GaryBlackbourne/raspberry-robot/resources/partlists/ctrl-board.md

# List of parts for the control board

## Microcontroller

- STM32F103C8T6 (LQFP-48): [link](https://hu.farnell.com/stmicroelectronics/stm32f103c8t6/mcu-32bit-cortex-m3-72mhz-lqfp/dp/1447637)
## Motor drivers

- BD6220F-E2 (servo driver) X 2: [link](https://hu.farnell.com/rohm/bd6220f-e2/h-bridge-driver-18v-0-5a-sop8/dp/1716260)

- TMC2208 module (step driver): [link](https://hu.farnell.com/trinamic/tmc2208silentstepstick/eval-board-stepper-motor-driver/dp/3861298)

## Connectors

- pin arrays
 - [1 x 6] 2.54mm male X 2
 - [1 x 5] 2.54mm male X 4
 - [2 x 5] 2.54mm female X 1
 - [1 x 4] 2.54mm male X 1
 - [1 x 3] 2.54mm male X 2

## LEDs

- 0805 SMD LED 

## buttons

- 6mm x 6mm x 9.5mm SMD PushButton X 2

## Passives

### Capacitors

All capacitors are SMD 0805 type components

- 100n X 7
- 1u X 1
- 47u X 4

### Resistors

All resistors are SMD 0805 type components

- 100 X 2 
- 1k X 1
- 4.7k X 4
- 10k X 6
- 100k X 2
