GaryBlackbourne/raspberry-robot/resources/partlists/mechanics.md

# List of mechanical parts

## Frame

## Motors

- N20E-06-25 (motor): [link](https://www.hestore.hu/prod_10042880.html)
- 17HS40-1204 léptetőmotor: [link](https://www.hestore.hu/prod_10036719.html)

## wheels
- N20-3PI-WHL (wheel): [link](https://www.hestore.hu/prod_10042770.html)
