GaryBlackbourne/raspberry-robot/doc/university/2_doc/msc_onlab_2_prezentacio.pdf

# Beágyazott Linux alapú modell autó

Készítette: Koloszár Gergely Konzulens: Bányász Gábor

# Motiváció

- önálló laboratórium 1 projekt folytatása
- Teljes rendszer megalkotása (közben mindenféle tapasztalat)
- hosszabb több féléves projekt ● hardware firmware és linux

driver összefüggések

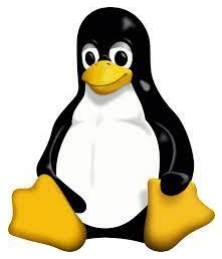
[picture p9: figure]
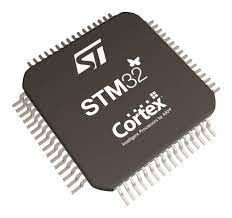
[picture p10: figure]
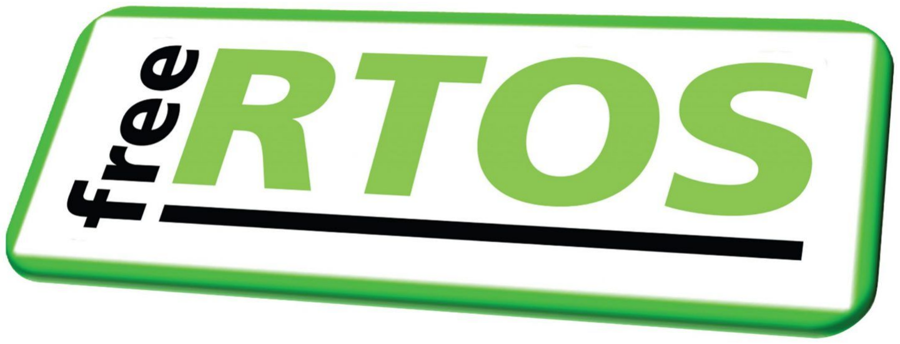
[picture p11: figure]

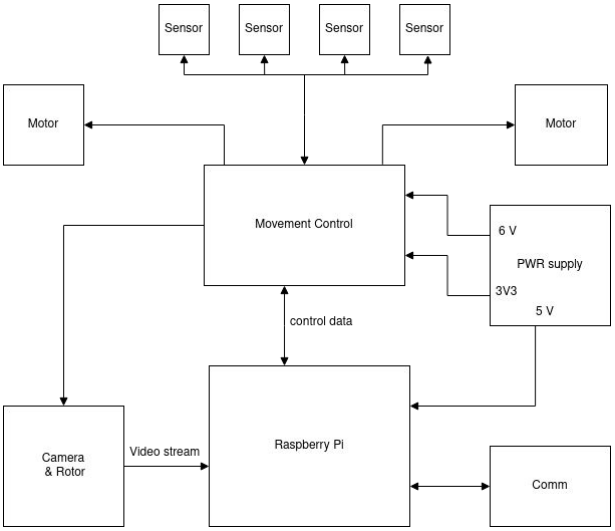
[picture p12: figure]

# A tervezett rendszer

A rendszer blokkdiagrammja

# Előrehaladások az elmúlt félévben

- Elkészült rendszerterv
- Kész alkatrész lista
- Kész PCB schematicok és layoutok
- Elkészült PCB-k

# Idei tervek

- forrasztás és élesztés
- firmware megírása
- linux driver megírása
- táp áramkört újra kellett tervezni

Ebből sajnos nem jött össze minden…

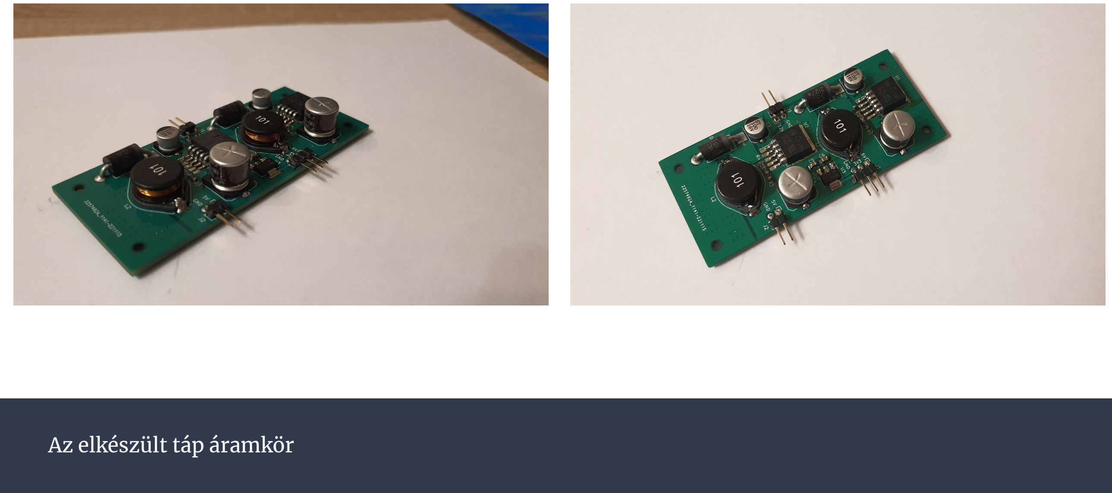
[picture p13: page 6]

Az elkészült táp áramkör

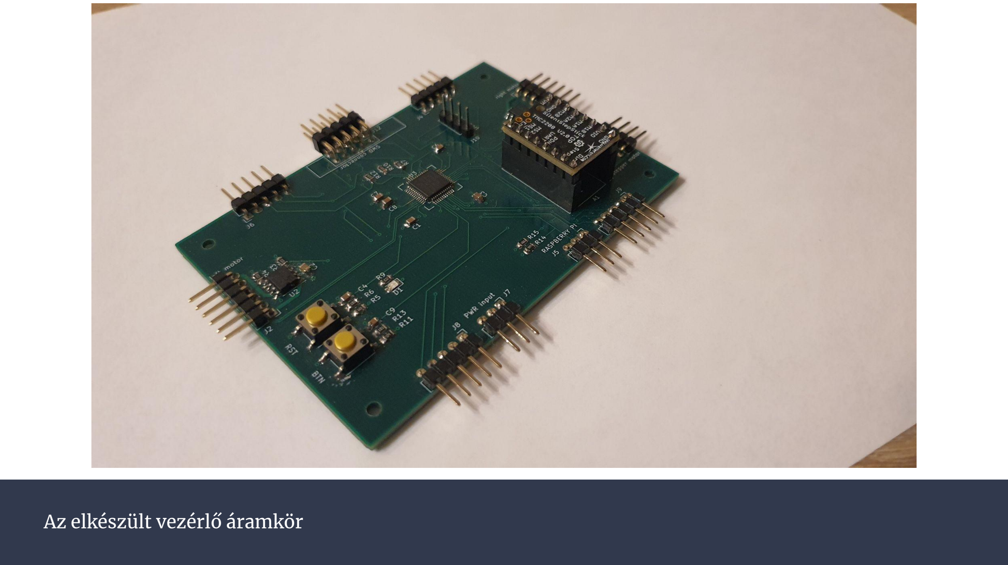
[picture p14: page 7]

Az elkészült vezérlő áramkör

A vezérléshez használt mikrovezérlő egy STM32F103C8.
A firmware megírásához több “keretrendszer” létezik:
- ST - HAL Driver
- ST - LL Driver
- ARM - CMSIS

# Firmware

És a fejlesztői környezetben is tág a választék:
- STM32CubeIDE
- IAR Workbench
- saját környezet

A választásom a saját környezetre, és a CMSIS rendszerre épül.
- alacsony szintről megérthetőek a működések
- CMSIS kód kompatibilis minden ARM mikrovezérlővel
- jobban személyre szabható a környezet

# Firmware

A projektben ezen felül a FreeRTOS operációs rendszerrel dolgozom

Lényegében a projekt befejezése: ● mechanikai váz ● működő akkumulátoros

tápellátás
- teljes linux driver ● teljes firmware ● felhasználói program

# Fejlesztési lehetőségek

# Köszönöm a figyelmet!
