GaryBlackbourne/raspberry-robot/doc/university/1_doc/hqxcd0-presentation.pdf

# Beágyazott Linux alapú modell autó

Készítette: Koloszár Gergely Konzulens: Bányász Gábor

# Motiváció

- teljes rendszer megépítése ● szoftver és hardver

interakcióban tapasztalat
szerzés
- Hosszabb, több féléves projekt

# A projekt célja

- Bővíthető rendszer
létrehozása:
- későbbi fejlesztések
könnyű eszközölhetősége
- többcélú eszköz, esetleg több konfigurációban is
használható
- Három fő területen való
fejlődés:
- PCB tervezés
- Firmware (STM32
platformon)
- Beágyazott Linux

# Specifikáció

- Egy önjáró vagy távirányítható kisautó létrehozása
- Moduláris elemekből ○ akkumulátoros tápellátás ○ motor vezérlés (STM32) ○ Központi vezérlés

(Raspberry Pi)
- Első konfiguráció ○ forgatható kamera ○ vezeték nélküli

kommunikáció


# A tervezett rendszer

A rendszer blokkdiagrammja

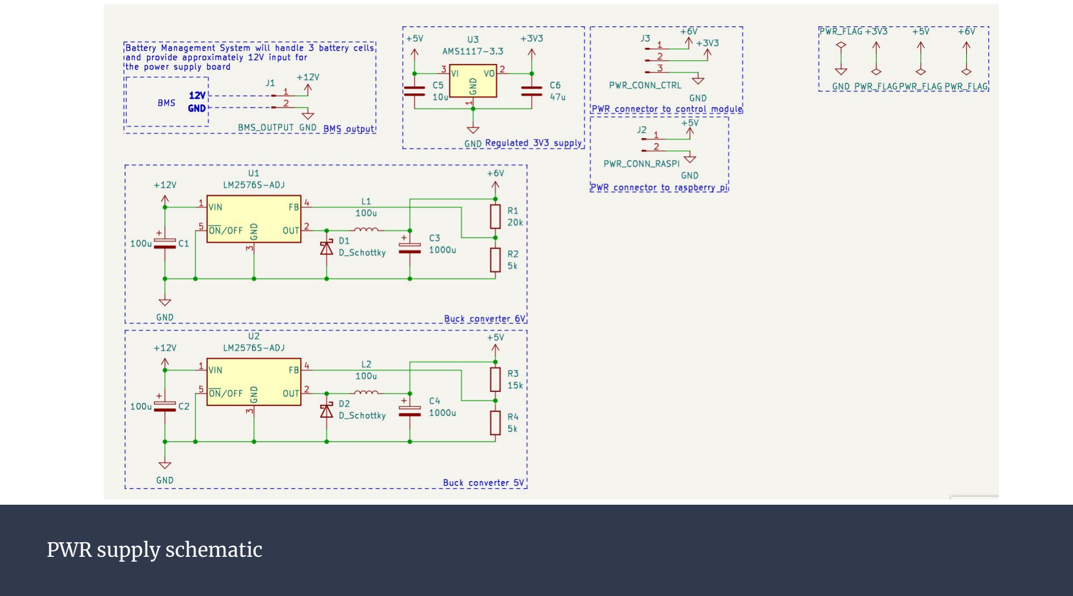
[picture p15: page 6]

PWR supply schematic

PWR supply layout

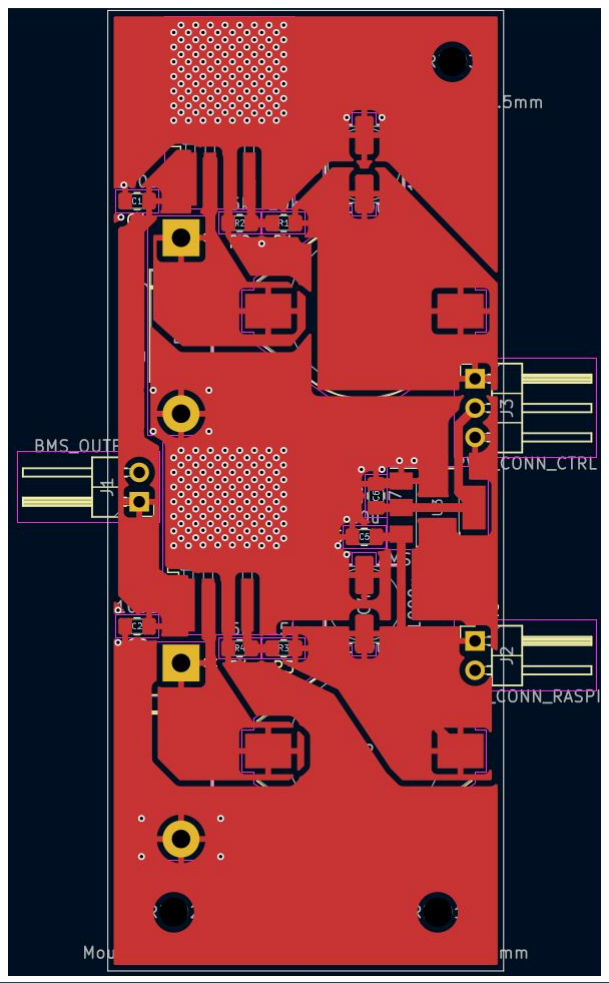
[picture p16: figure]

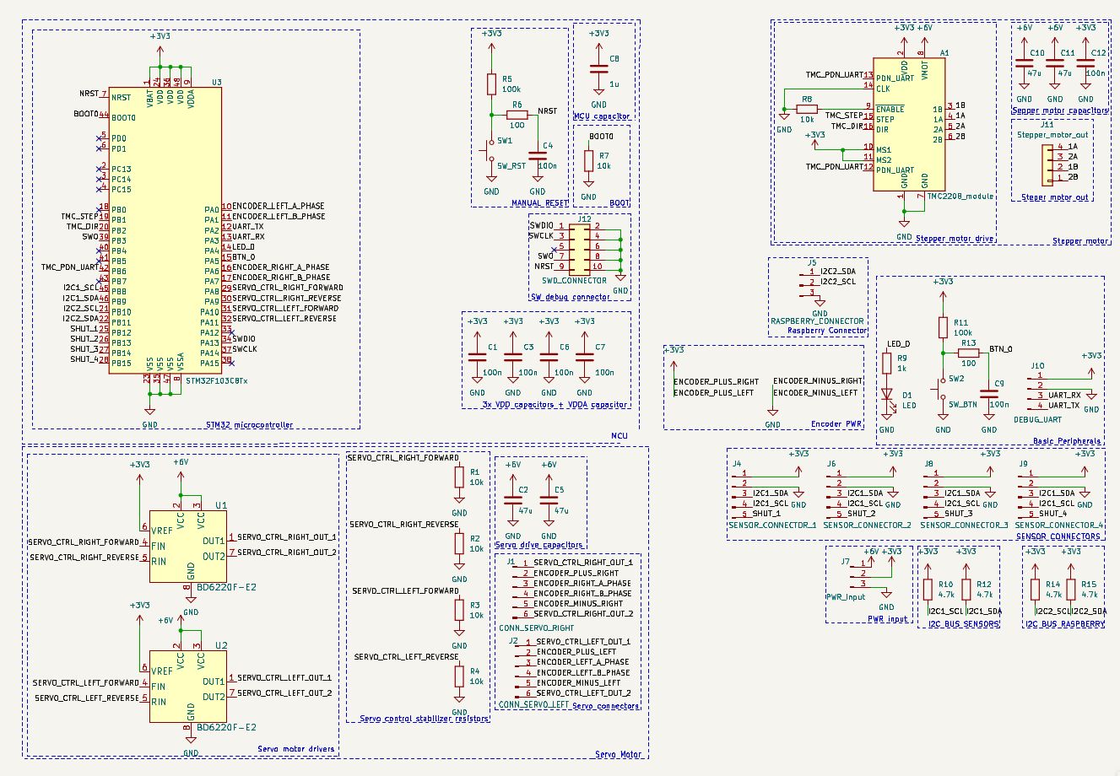
[picture p17: figure]

Movement control schematic

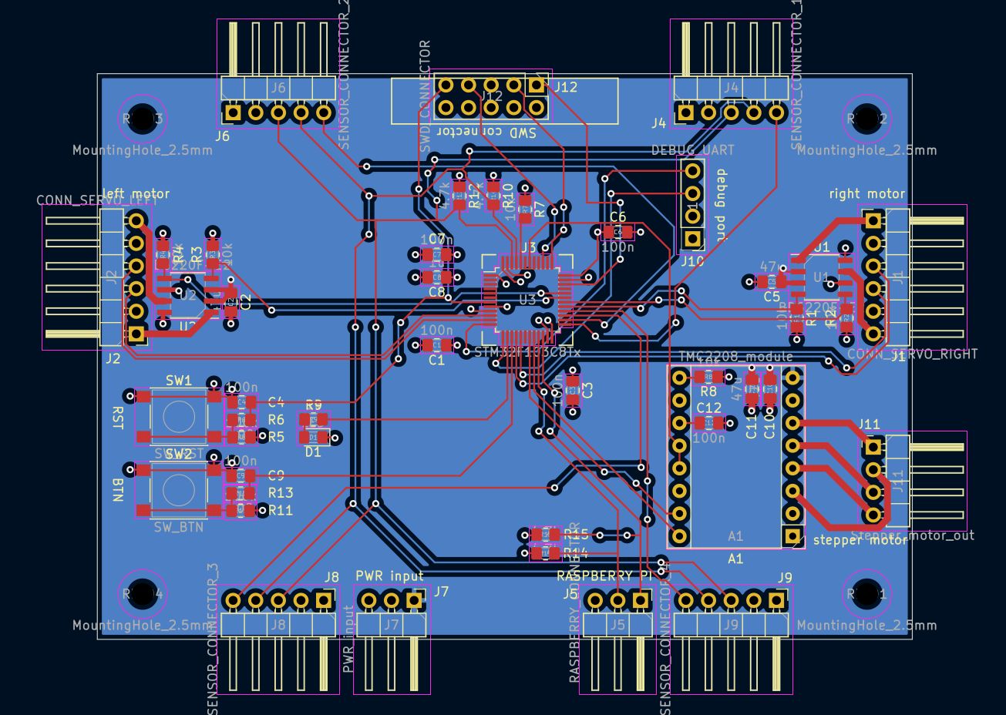
[picture p18: figure]

Movement control layout

# Fejlesztési lehetőségek

- gyorsulás mérő ● nagyobb távolságú vezeték

nélküli kommunikációs modul
- saját akkumulátor
management
- töltési lehetőség megbontás nélkül

# Köszönöm a figyelmet!
