GaryBlackbourne/raspberry-robot/doc/schemas/auto-schema.drawio.png

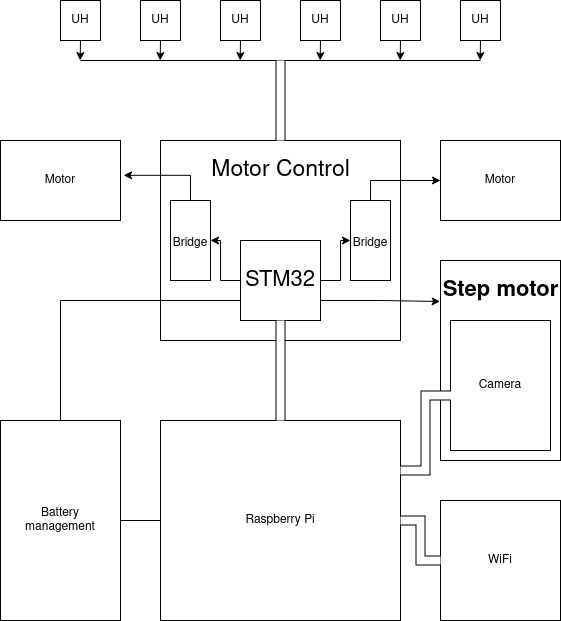
doc/schemas/auto-schema.drawio.png
