GaryBlackbourne/raspberry-robot/resources/partlists/pwr-supply.md

# List of parts for the power supply board

## Switching power supply IC-s

## LDO-s
- AMS1117-3.3 (regulator): 

## Connectors

- [1 x 2] 2.54mm male X 2
- [1 x 3] 2.54mm male X 1

## Passives 

### Capacitors

- 10u 0805 X 1
- 47u 0805 X 1
- 100u 6.3x7.7 X 2
- 1000u 10x10 X 2

### Resistors

All resistors are SMD 0805 type components

- 5k X 2
- 15k X 1
- 20k X 1

### Inductors

- 100u X 2

### Diodes

- 

# List of parts for the Battery module

- BMS
- 18650 battery (30W) [link](https://www.intercell.hu/samsung_18650_37v_3500mah_inr18650-35e_li-ion_ipari_cella_akkuakkumulator_31873)
- battery nest [link](https://www.intercell.hu/li_ion_18650_akkuakkumulator_tartofeszek_3_cellas_sorosparhuzamos_17129)
