GaryBlackbourne/raspberry-robot/resources/partlists/sensors.md

# List of sensors

## Range sensors:
 - VL53L1 SATEL modul: [link](https://hu.farnell.com/stmicroelectronics/vl53l1-satel/breakout-board-tof-proximity-sensor/dp/3528437)
