GaryBlackbourne/raspberry-robot/mechanics/frame.dxf

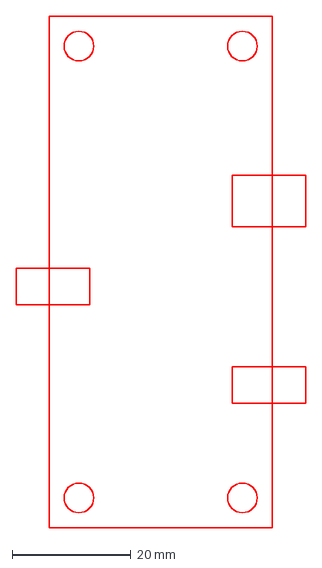
[picture p20: CAD file, 2023-08-11]
mechanics/frame.dxf
48.7 x 86.0 mm
