GaryBlackbourne/raspberry-robot/doc/schemas/circuits/ctrl-board/movement-control-schematic.pdf

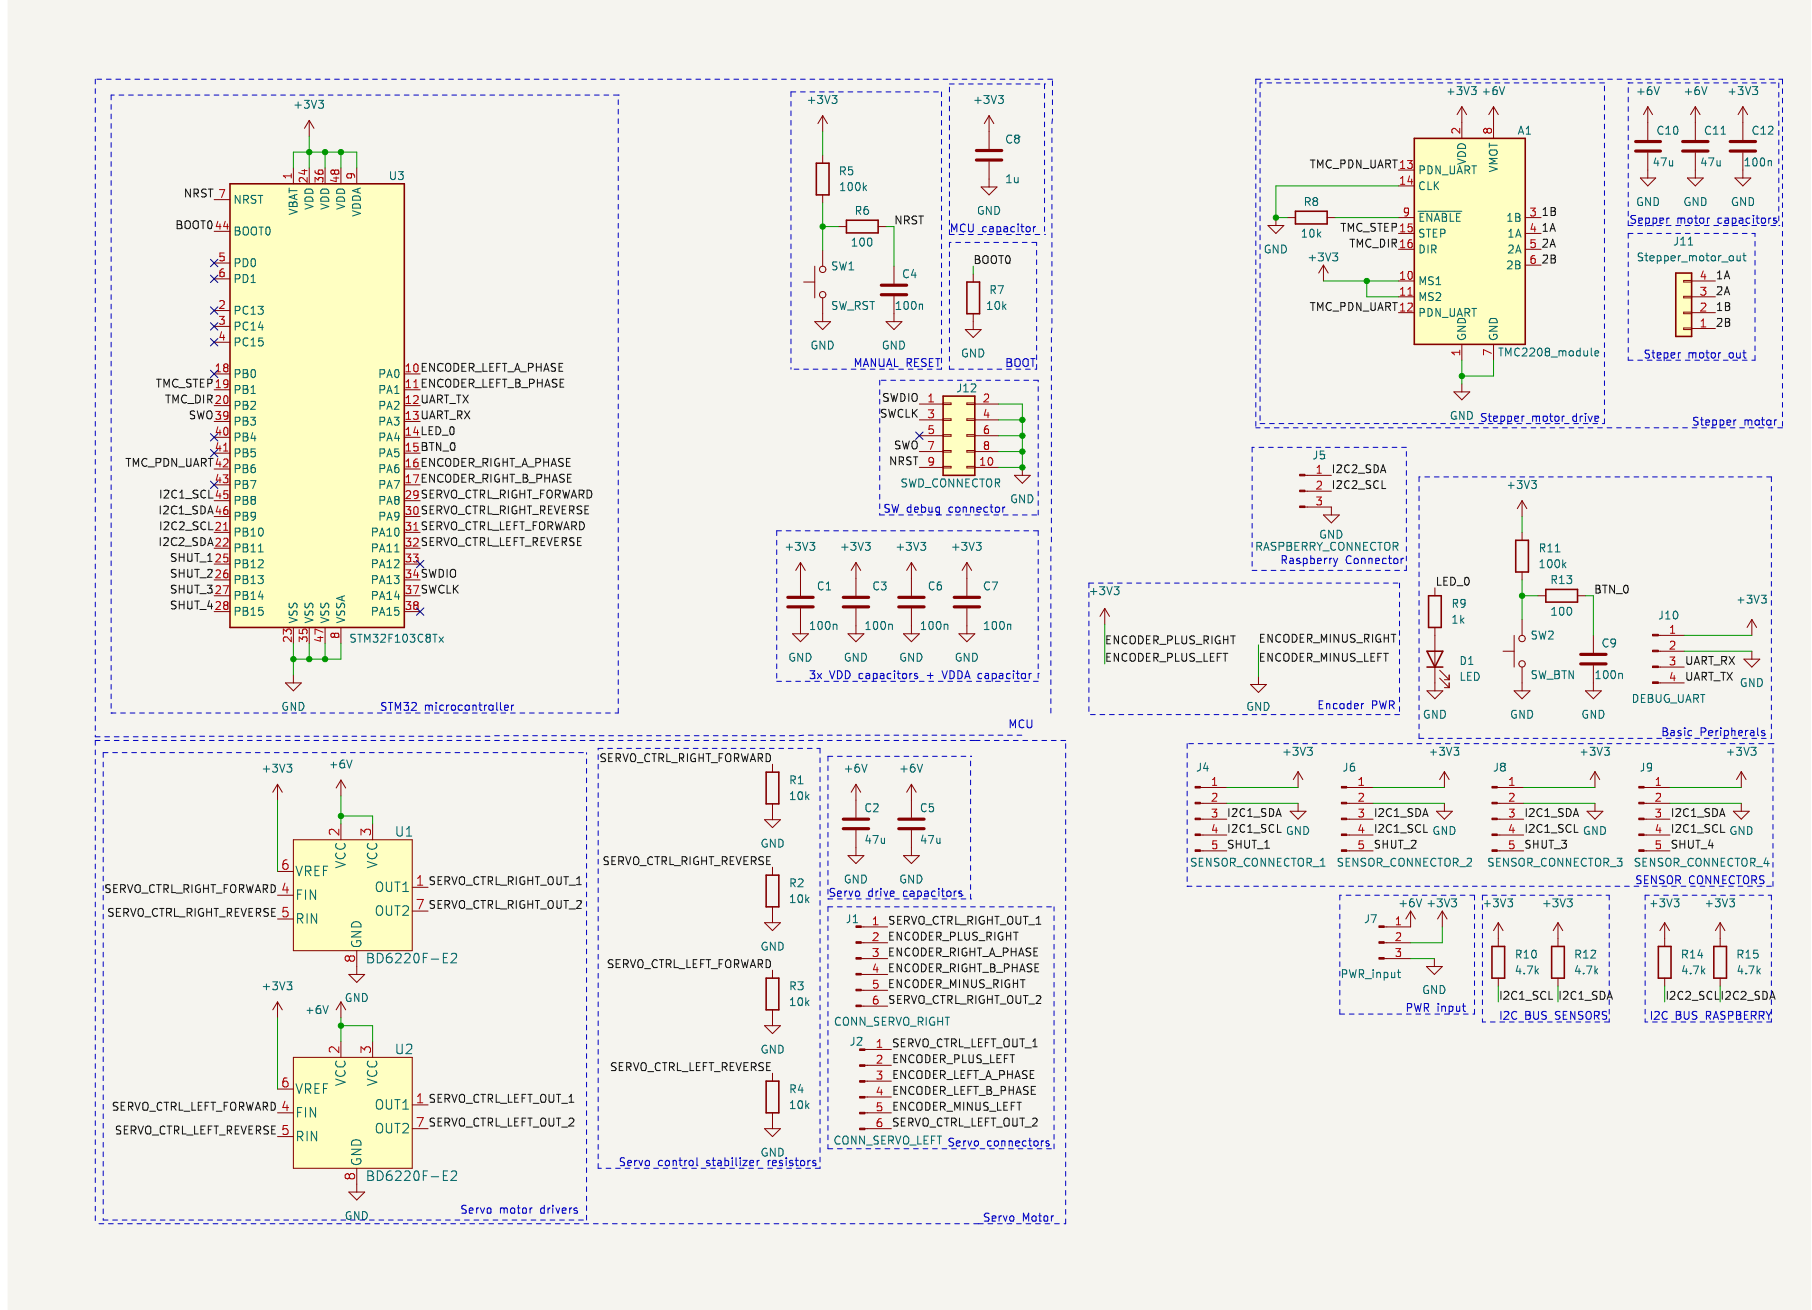
[picture p21: page 1]
