GaryBlackbourne/raspberry-robot/doc/schemas/circuits/pwr-supply/power-supply-unit-schematic.pdf

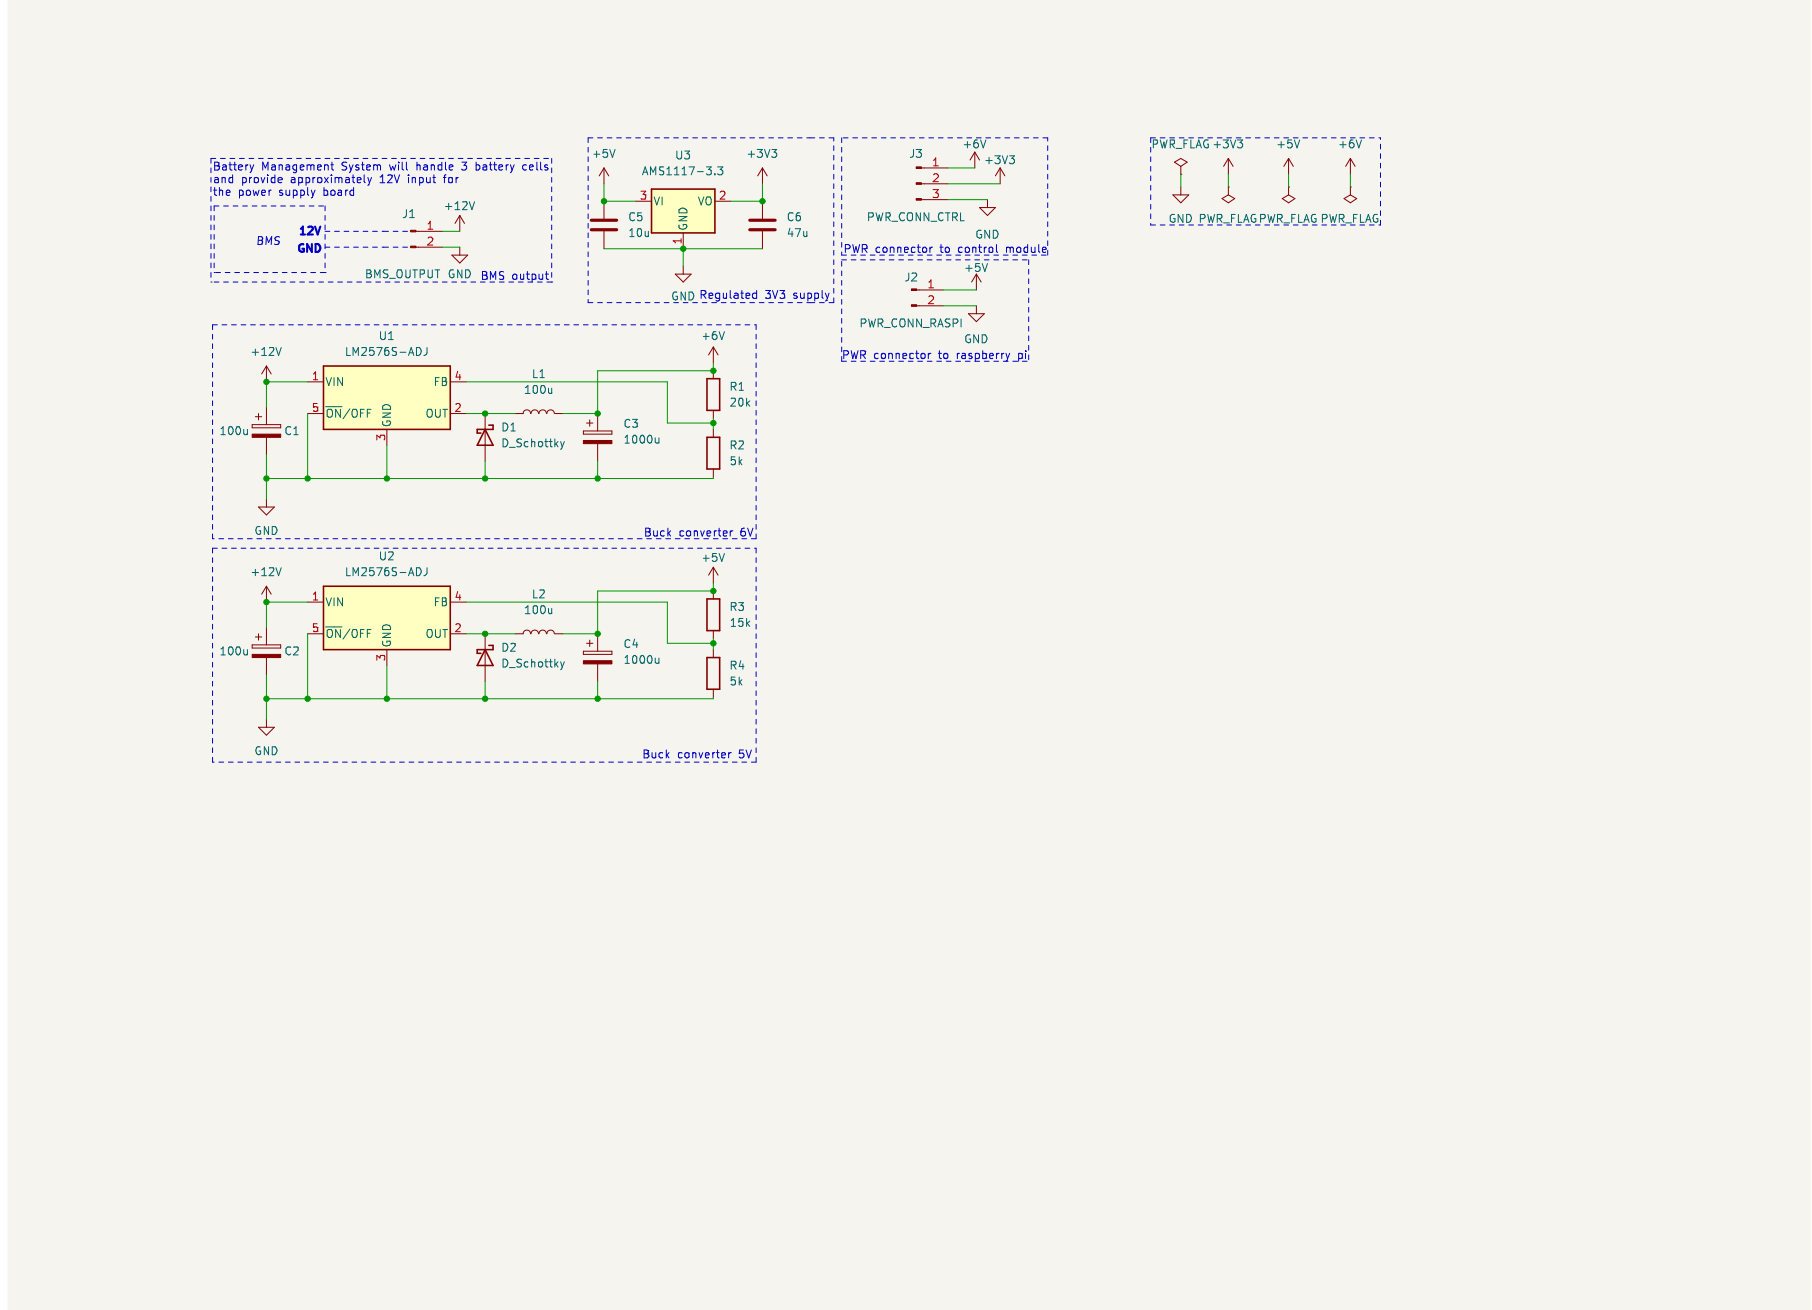
[picture p22: page 1]
