GaryBlackbourne/raspberry-robot/doc/schemas/circuits/ctrl-board/movement-control-layout.pdf

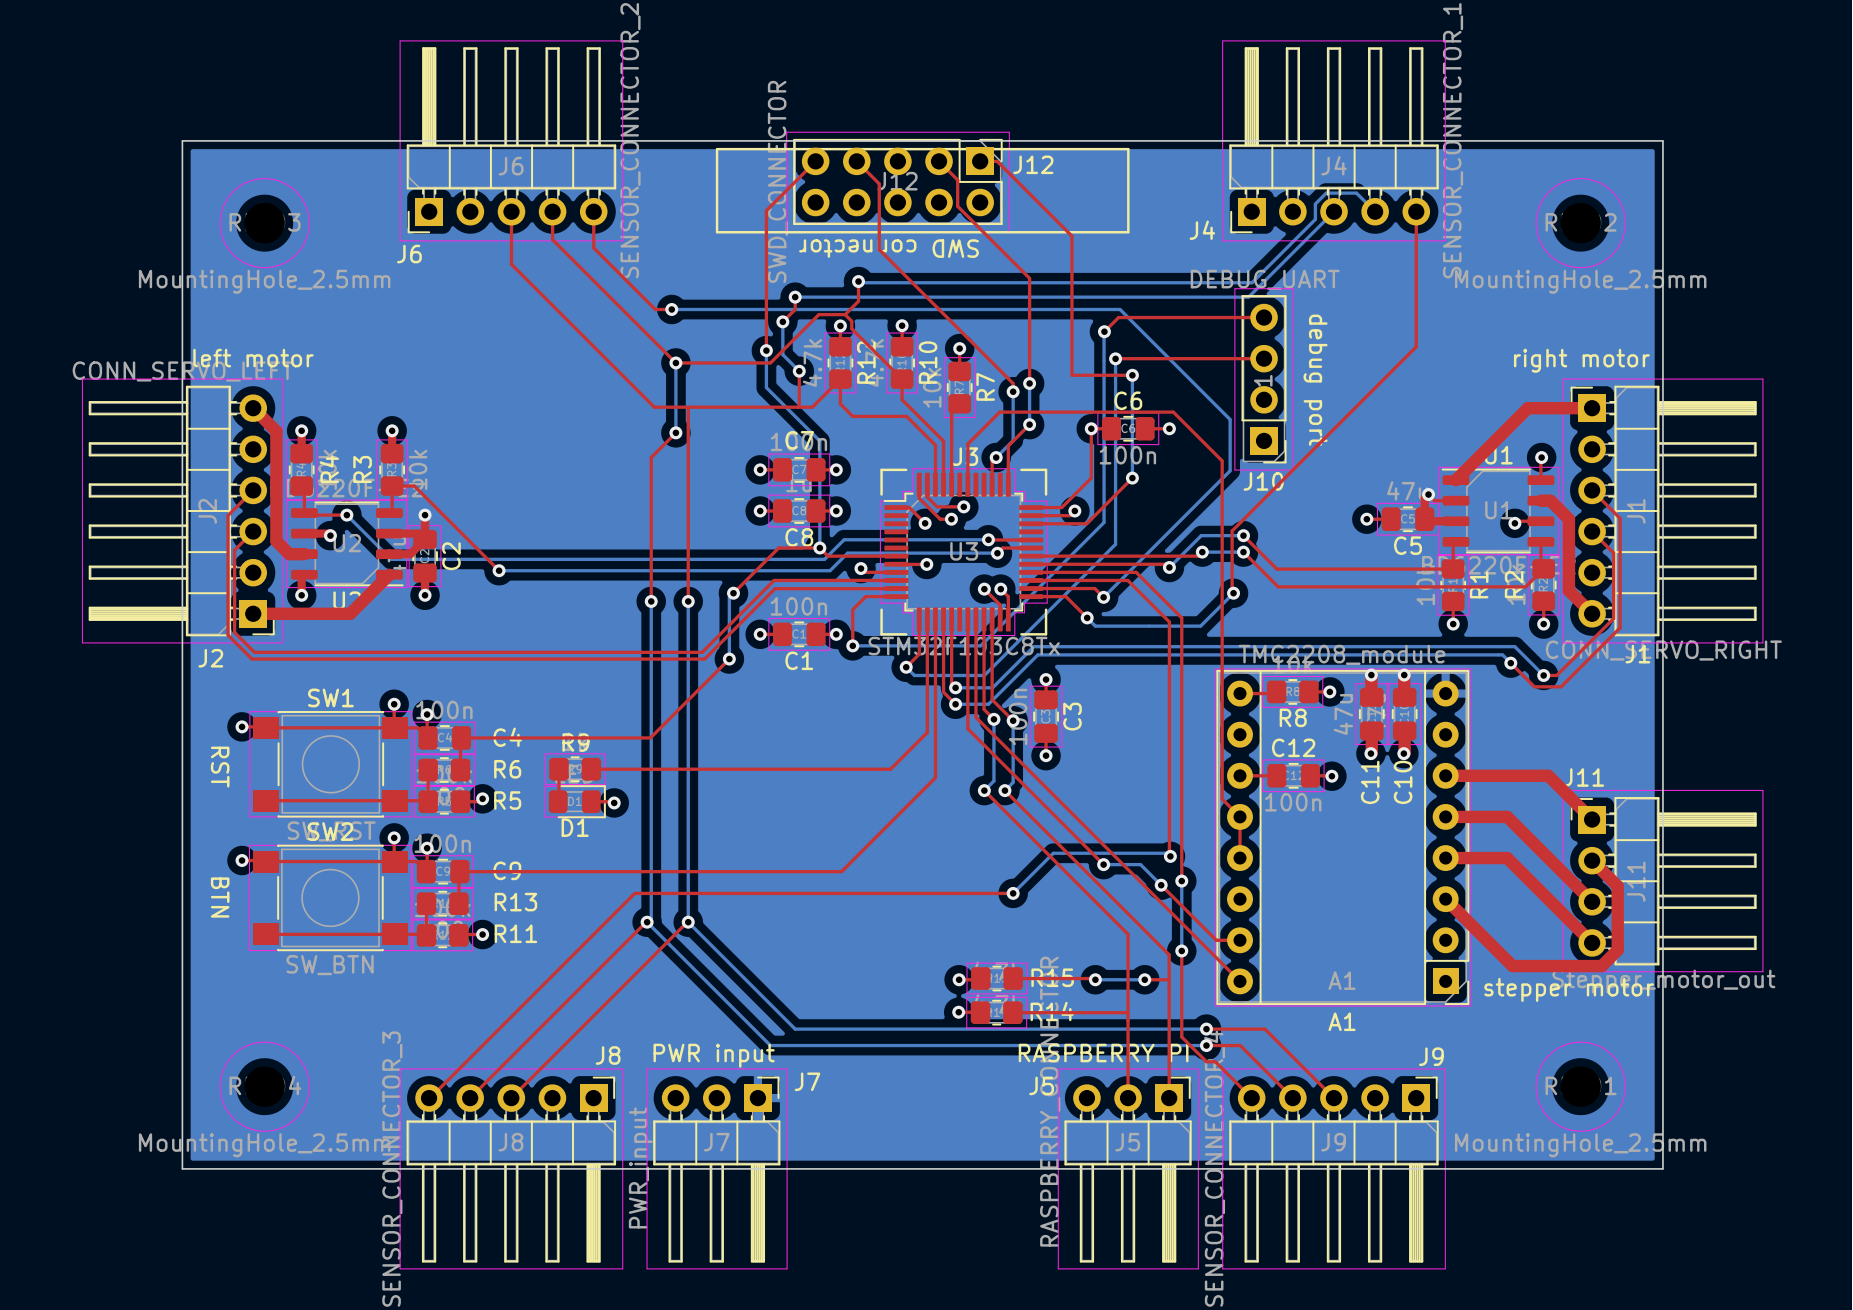
[picture p23: page 1]
