GaryBlackbourne/raspberry-robot/doc/schemas/circuits/pwr-supply/power-supply-unit-layout.pdf

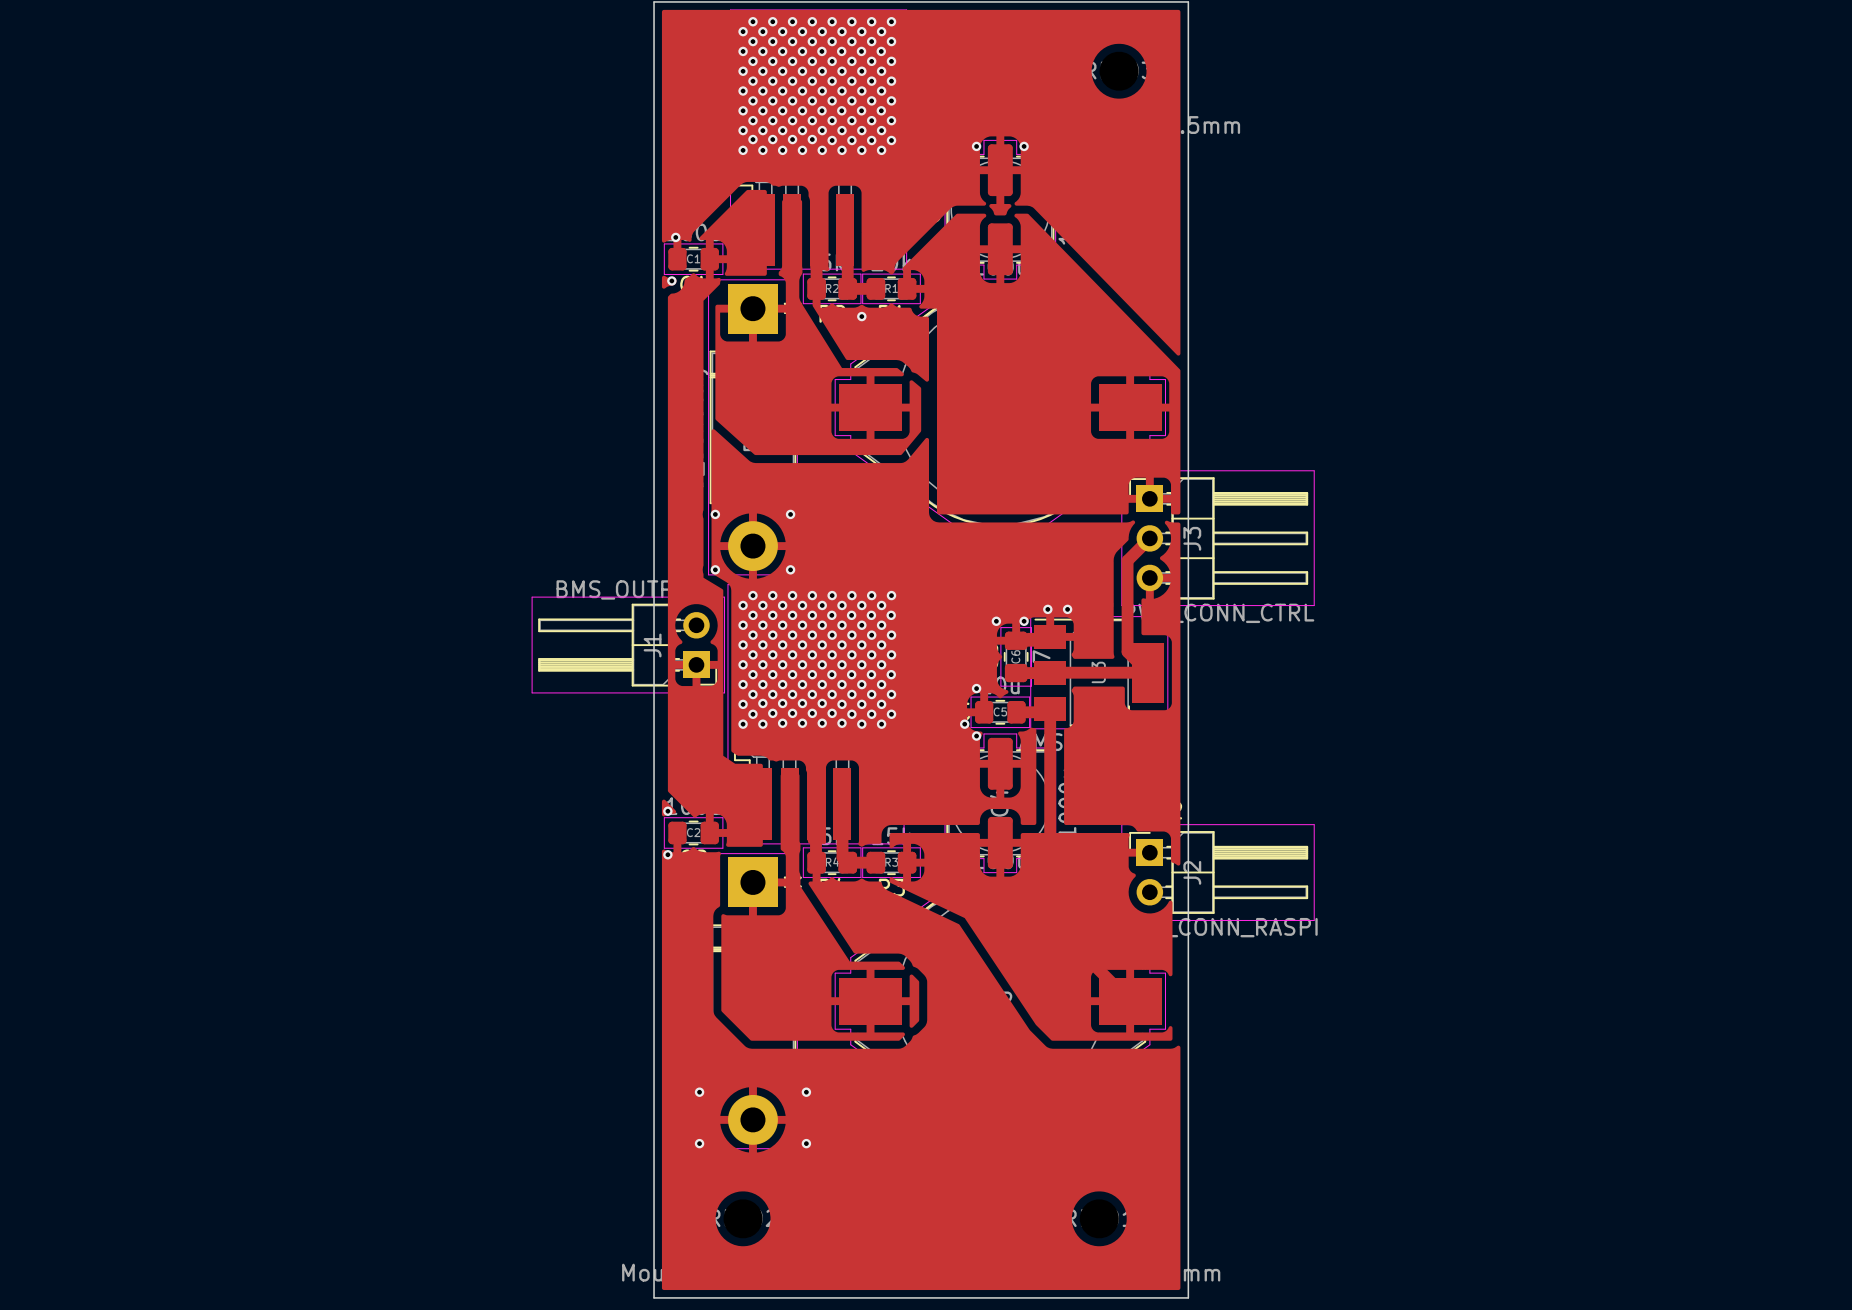
[picture p24: page 1]
