GaryBlackbourne/raspberry-robot/pcbs/power-supply-unit/power-supply-unit.kicad_pcb

## KiCad design pcbs/power-supply-unit/power-supply-unit.kicad_pcb (2023-08-10)

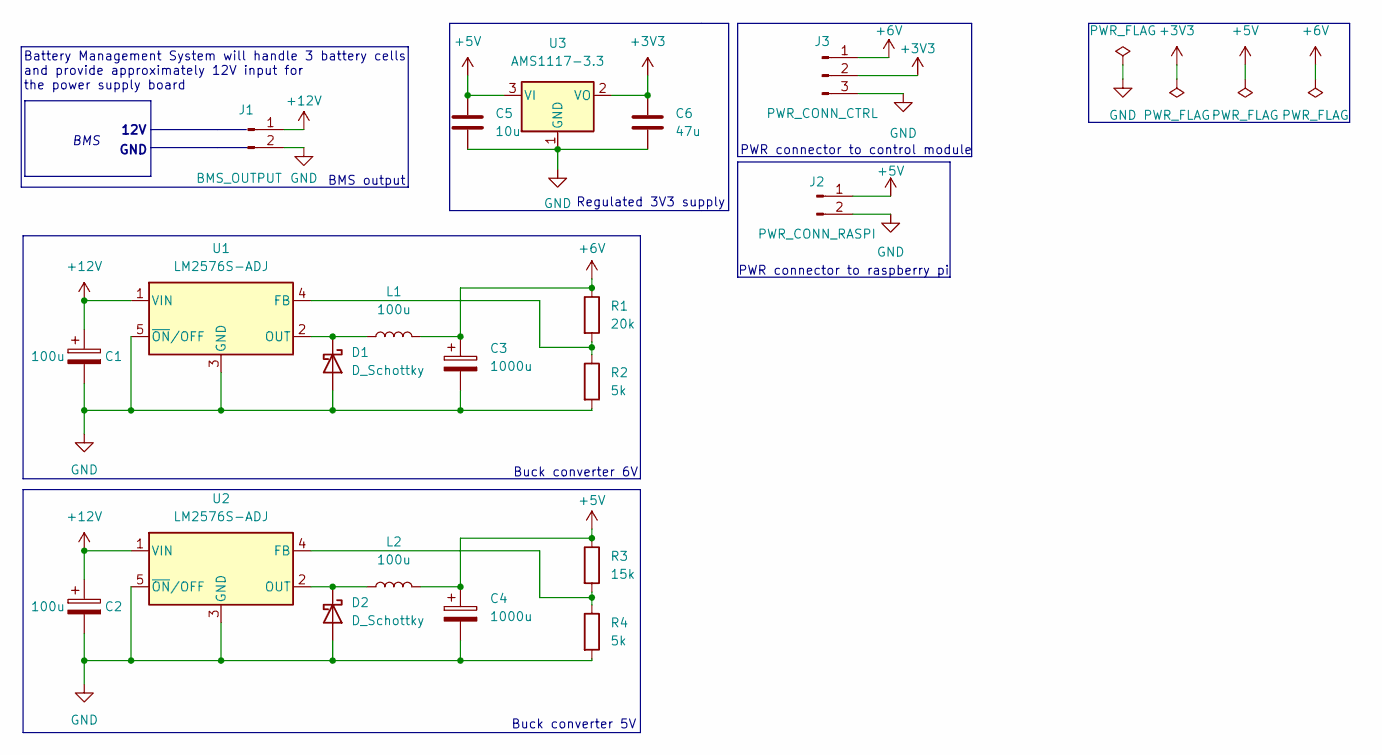
[picture p25: schematic power-supply-unit.kicad_sch]

Parts:
C1, C2: 100u; C_Elec_6.3x7.7
C3, C4: 1000u; C_Elec_10x10.2
C5: 10u; C_0805_2012Metric_Pad1.18x1.45mm_HandSolder
C6: 47u; C_0805_2012Metric_Pad1.18x1.45mm_HandSolder
D1, D2: D_Schottky; D_DO-201AD_P15.24mm_Horizontal
J1: BMS_OUTPUT; PinHeader_1x02_P2.54mm_Horizontal
J2: PWR_CONN_RASPI; PinHeader_1x02_P2.54mm_Horizontal
J3: PWR_CONN_CTRL; PinHeader_1x03_P2.54mm_Horizontal
L1, L2: 100u; L_Fastron_PISR_Handsoldering
R1: 20k; R_0805_2012Metric_Pad1.20x1.40mm_HandSolder
R2, R4: 5k; R_0805_2012Metric_Pad1.20x1.40mm_HandSolder
R3: 15k; R_0805_2012Metric_Pad1.20x1.40mm_HandSolder
U1, U2: LM2576S-ADJ; TO-263-5_TabPin3
U3: AMS1117-3.3; SOT-223-3_TabPin2

Connections:
+3V3: C6.1, J3.2, U3.2 (VO)
+5V: C4.1, C5.1, J2.1, L2.2, R3.1, U3.3 (VI)
+6V: C3.1, J3.1, L1.2, R1.1
+12V: C1.1, C2.1, J1.1, U1.1 (VIN), U2.1 (VIN)
GND: C1.2, C2.2, C3.2, C4.2, C5.2, C6.2, D1.2 (A), D2.2 (A), J1.2, J2.2, J3.3, R2.2, R4.2, U1.3 (GND), U1.5 (~ON/OFF), U2.3 (GND), U2.5 (~ON/OFF), U3.1 (GND)
unnamed: D1.1 (K), L1.1, U1.2 (OUT)
unnamed: D2.1 (K), L2.1, U2.2 (OUT)
unnamed: R1.2, R2.1, U1.4 (FB)
unnamed: R3.2, R4.1, U2.4 (FB)

Notes on the sheet:
GND
PWR connector to control module
PWR connector to raspberry pi
Buck converter 6V
BMS output
Regulated 3V3 supply
12V
Buck converter 5V
BMS
Battery Management System will handle 3 battery cells and provide approximately 12V input for the power supply board

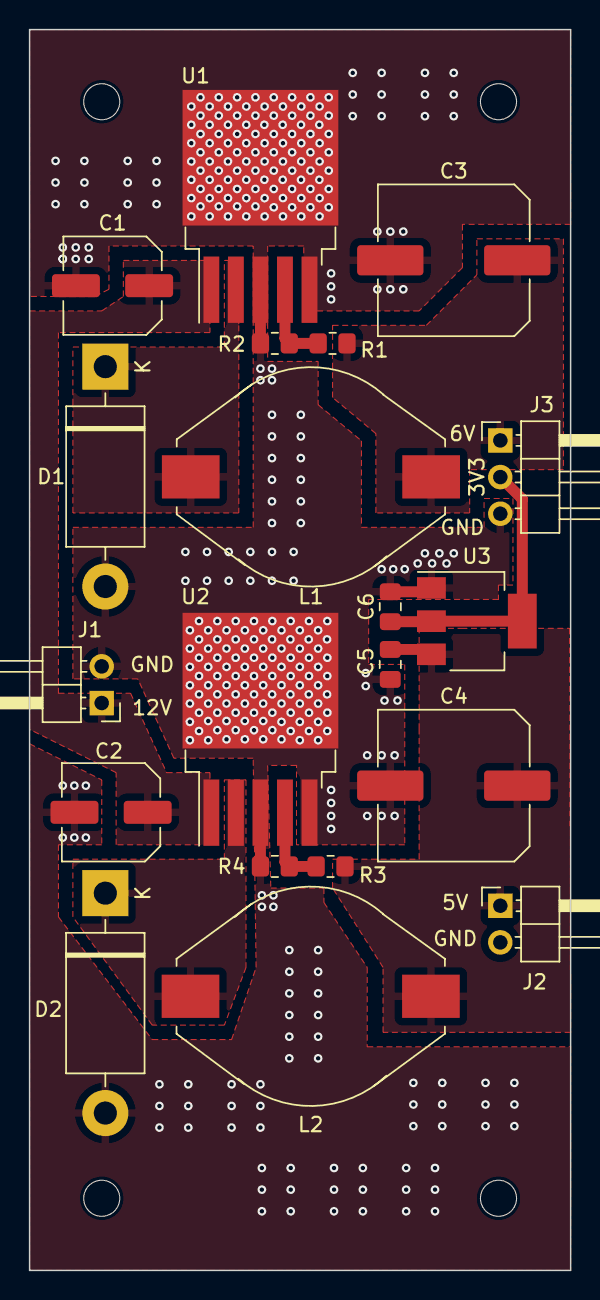
[picture p26: board power-supply-unit.kicad_pcb from above]

Board: 2 copper layers, 37.5 x 86.0 mm, 24 parts (0 on the bottom side), 9 nets.

Other parts of the board:
REF01, REF02, REF03, REF03#2: MountingHole_2.5mm
