GaryBlackbourne/raspberry-robot/pcbs/movement-control/movement-control.kicad_pcb

## KiCad design pcbs/movement-control/movement-control.kicad_pcb (2022-05-04)

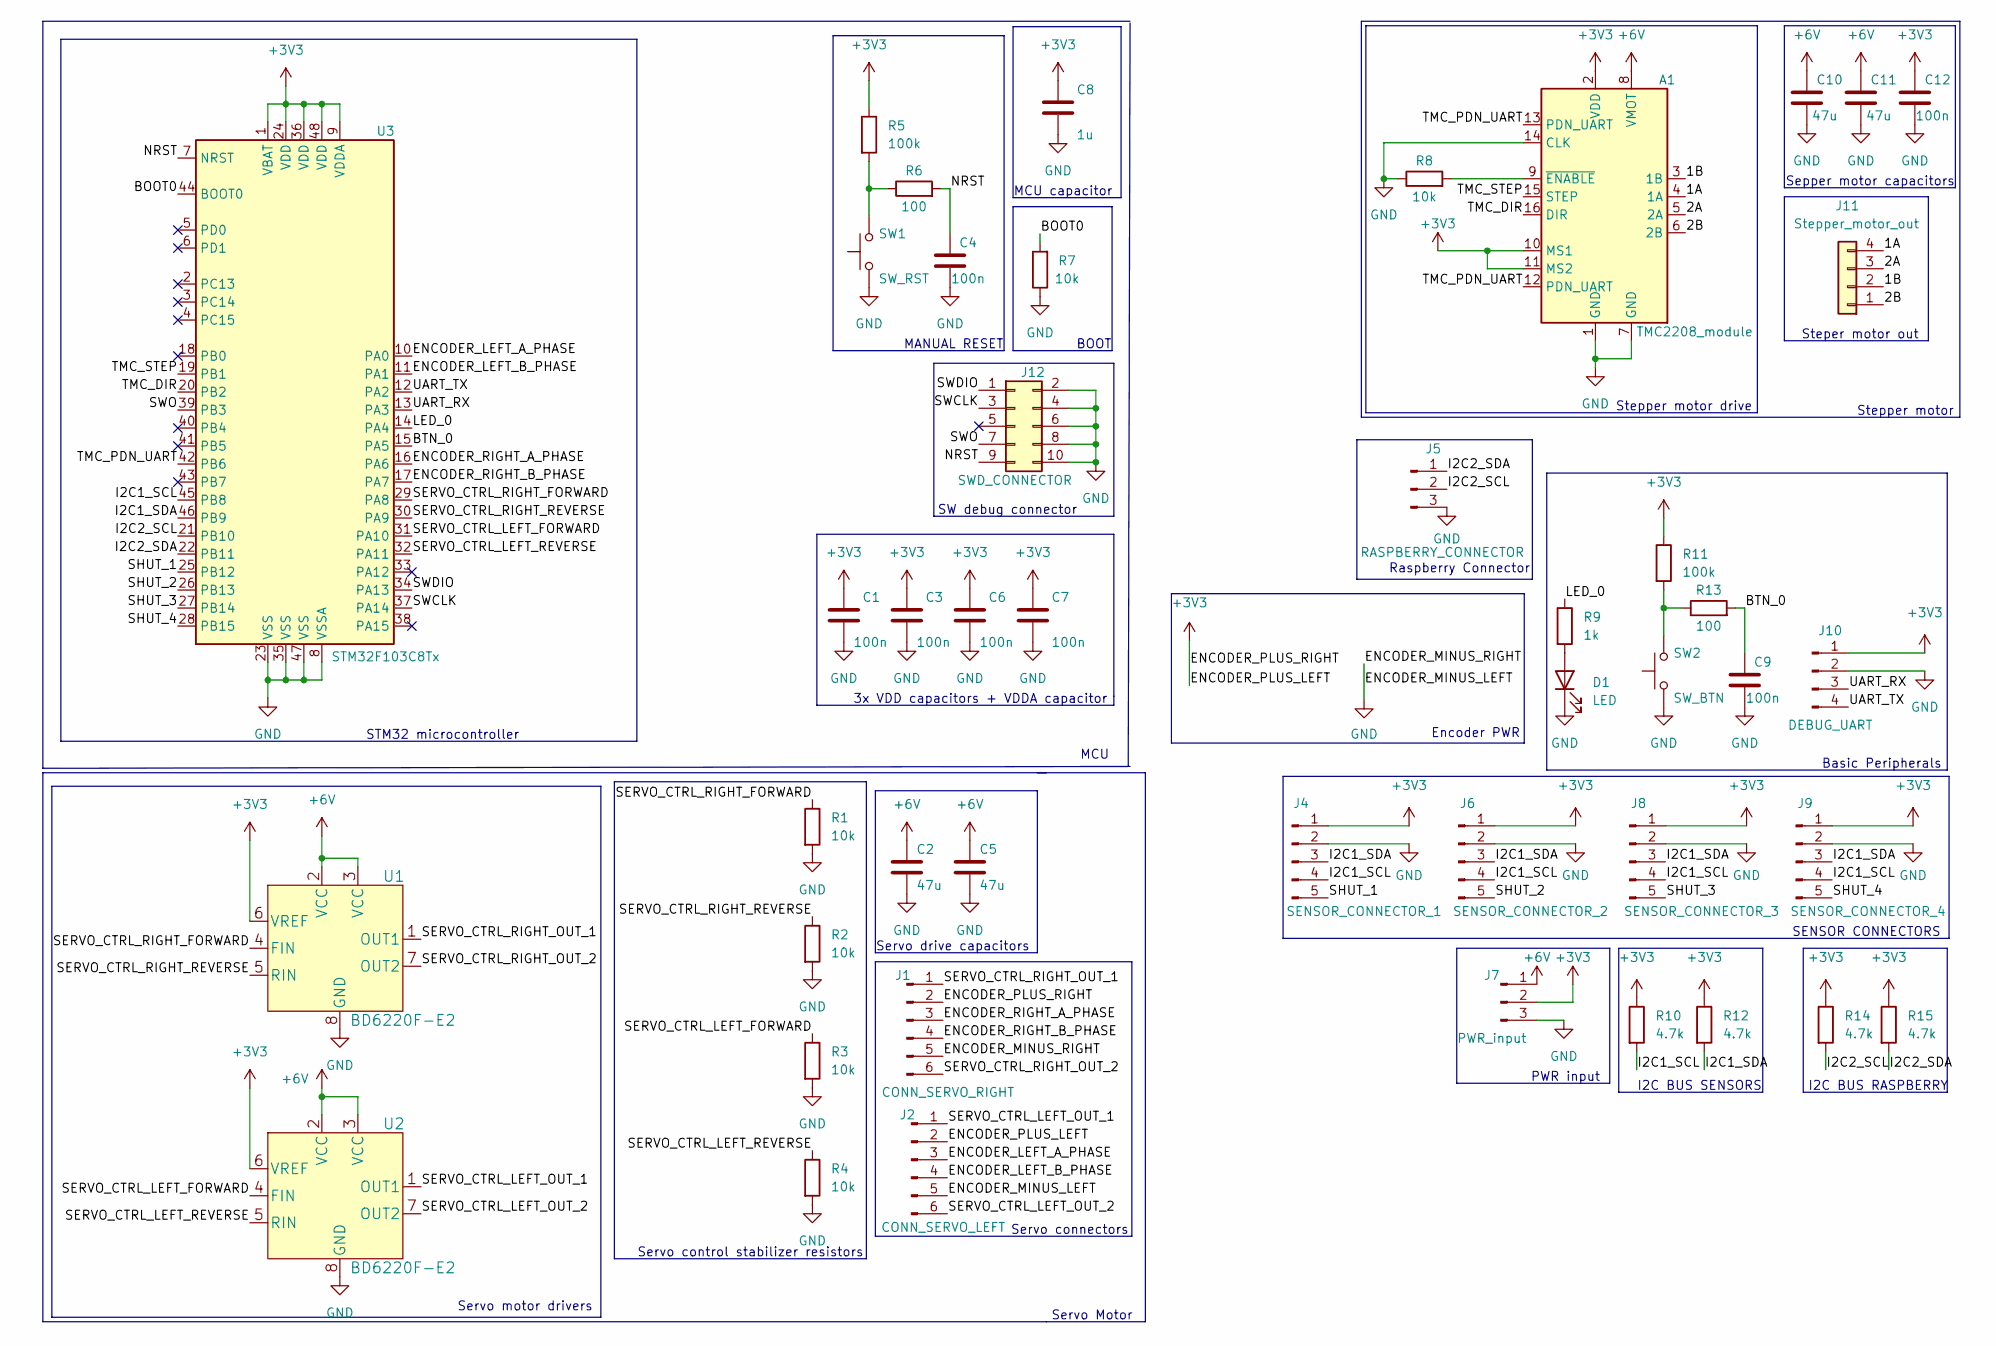
[picture p27: schematic movement-control.kicad_sch, Motor Control Board]

Parts:
A1: TMC2208_module; Pololu_Breakout-16_15.2x20.3mm
C1, C3, C4, C6, C7, C9, C12: 100n; C_0805_2012Metric_Pad1.18x1.45mm_HandSolder
C2, C5, C10, C11: 47u; C_0805_2012Metric_Pad1.18x1.45mm_HandSolder
C8: 1u; C_0805_2012Metric_Pad1.18x1.45mm_HandSolder
D1: LED; LED_0805_2012Metric_Pad1.15x1.40mm_HandSolder
J1: CONN_SERVO_RIGHT; PinHeader_1x06_P2.54mm_Horizontal
J2: CONN_SERVO_LEFT; PinHeader_1x06_P2.54mm_Horizontal
J4: SENSOR_CONNECTOR_1; PinHeader_1x05_P2.54mm_Horizontal
J5: RASPBERRY_CONNECTOR; PinHeader_1x03_P2.54mm_Horizontal
J6: SENSOR_CONNECTOR_2; PinHeader_1x05_P2.54mm_Horizontal
J7: PWR_input; PinHeader_1x03_P2.54mm_Horizontal
J8: SENSOR_CONNECTOR_3; PinHeader_1x05_P2.54mm_Horizontal
J9: SENSOR_CONNECTOR_4; PinHeader_1x05_P2.54mm_Horizontal
J10: DEBUG_UART; PinHeader_1x04_P2.54mm_Vertical
J11: Stepper_motor_out; PinHeader_1x04_P2.54mm_Horizontal
J12: SWD_CONNECTOR; PinHeader_2x05_P2.54mm_Vertical
R1, R2, R3, R4, R7, R8: 10k; R_0805_2012Metric_Pad1.20x1.40mm_HandSolder
R5, R11: 100k; R_0805_2012Metric_Pad1.20x1.40mm_HandSolder
R6, R13: 100; R_0805_2012Metric_Pad1.20x1.40mm_HandSolder
R9: 1k; R_0805_2012Metric_Pad1.20x1.40mm_HandSolder
R10, R12, R14, R15: 4.7k; R_0805_2012Metric_Pad1.20x1.40mm_HandSolder
SW1: SW_RST; SW_Push_1P1T_NO_6x6mm_H9.5mm
SW2: SW_BTN; SW_Push_1P1T_NO_6x6mm_H9.5mm
U1, U2: BD6220F-E2; SOP-8_3.9x4.9mm_P1.27mm
U3: STM32F103C8Tx; LQFP-48_7x7mm_P0.5mm

Connections:
+3V3: A1.2 (VDD), A1.10 (MS1), A1.11 (MS2), C1.1, C3.1, C6.1, C7.1, C8.1, C12.1, J1.2, J2.2, J4.1, J6.1, J7.2, J8.1, J9.1, J10.1, R5.1, R10.1, R11.1, R12.1, R14.1, R15.1, U1.6 (VREF), U2.6 (VREF), U3.1 (VBAT), U3.9 (VDDA), U3.24 (VDD), U3.36 (VDD), U3.48 (VDD)
+6V: A1.8 (VMOT), C2.1, C5.1, C10.1, C11.1, J7.1, U1.2 (VCC), U1.3 (VCC), U2.2 (VCC), U2.3 (VCC)
/1A: A1.4 (1A), J11.4
/1B: A1.3 (1B), J11.2
/2A: A1.5 (2A), J11.3
/2B: A1.6 (2B), J11.1
/BOOT0: R7.2, U3.44 (BOOT0)
/BTN_0: C9.1, R13.2, U3.15 (PA5)
/ENCODER_LEFT_A_PHASE: J2.3, U3.10 (PA0)
/ENCODER_LEFT_B_PHASE: J2.4, U3.11 (PA1)
/ENCODER_RIGHT_A_PHASE: J1.3, U3.16 (PA6)
/ENCODER_RIGHT_B_PHASE: J1.4, U3.17 (PA7)
/I2C1_SCL: J4.4, J6.4, J8.4, J9.4, R10.2, U3.45 (PB8)
/I2C1_SDA: J4.3, J6.3, J8.3, J9.3, R12.2, U3.46 (PB9)
/I2C2_SCL: J5.2, R14.2, U3.21 (PB10)
/I2C2_SDA: J5.1, R15.2, U3.22 (PB11)
/LED_0: R9.1, U3.14 (PA4)
/NRST: C4.1, J12.9, R6.2, U3.7 (NRST)
/SERVO_CTRL_LEFT_FORWARD: R3.1, U2.4 (FIN), U3.31 (PA10)
/SERVO_CTRL_LEFT_OUT_1: J2.1, U2.1 (OUT1)
/SERVO_CTRL_LEFT_OUT_2: J2.6, U2.7 (OUT2)
/SERVO_CTRL_LEFT_REVERSE: R4.1, U2.5 (RIN), U3.32 (PA11)
/SERVO_CTRL_RIGHT_FORWARD: R1.1, U1.4 (FIN), U3.29 (PA8)
/SERVO_CTRL_RIGHT_OUT_1: J1.1, U1.1 (OUT1)
/SERVO_CTRL_RIGHT_OUT_2: J1.6, U1.7 (OUT2)
/SERVO_CTRL_RIGHT_REVERSE: R2.1, U1.5 (RIN), U3.30 (PA9)
/SHUT_1: J4.5, U3.25 (PB12)
/SHUT_2: J6.5, U3.26 (PB13)
/SHUT_3: J8.5, U3.27 (PB14)
/SHUT_4: J9.5, U3.28 (PB15)
/SWCLK: J12.3, U3.37 (PA14)
/SWDIO: J12.1, U3.34 (PA13)
/SWO: J12.7, U3.39 (PB3)
/TMC_DIR: A1.16 (DIR), U3.20 (PB2)
/TMC_PDN_UART: A1.12 (PDN_UART), A1.13 (PDN_UART), U3.42 (PB6)
/TMC_STEP: A1.15 (STEP), U3.19 (PB1)
/UART_RX: J10.3, U3.13 (PA3)
/UART_TX: J10.4, U3.12 (PA2)
GND: A1.1 (GND), A1.7 (GND), A1.14 (CLK), C1.2, C2.2, C3.2, C4.2, C5.2, C6.2, C7.2, C8.2, C9.2, C10.2, C11.2, C12.2, D1.1 (K), J1.5, J2.5, J4.2, J5.3, J6.2, J7.3, J8.2, J9.2, J10.2, J12.2, J12.4, J12.6, J12.8, J12.10, R1.2, R2.2, R3.2, R4.2, R7.1, R8.1, SW1.1, SW2.1, U1.8 (GND), U2.8 (GND), U3.8 (VSSA), U3.23 (VSS), U3.35 (VSS), U3.47 (VSS)
unnamed: A1.9 (~ENABLE), R8.2
unnamed: D1.2 (A), R9.2
unnamed: R5.2, R6.1, SW1.2
unnamed: R11.2, R13.1, SW2.2

Notes on the sheet:
BOOT
MANUAL RESET
STM32 microcontroller
Sepper motor capacitors
I2C BUS SENSORS
MCU
Steper motor out
Servo control stabilizer resistors
Servo drive capacitors
Servo Motor
Raspberry Connector
3x VDD capacitors + VDDA capacitor
Basic Peripherals
Stepper motor drive
SW debug connector
MCU capacitor
Servo connectors
Encoder PWR
Stepper motor
Servo motor drivers
I2C BUS RASPBERRY
SENSOR CONNECTORS
PWR input

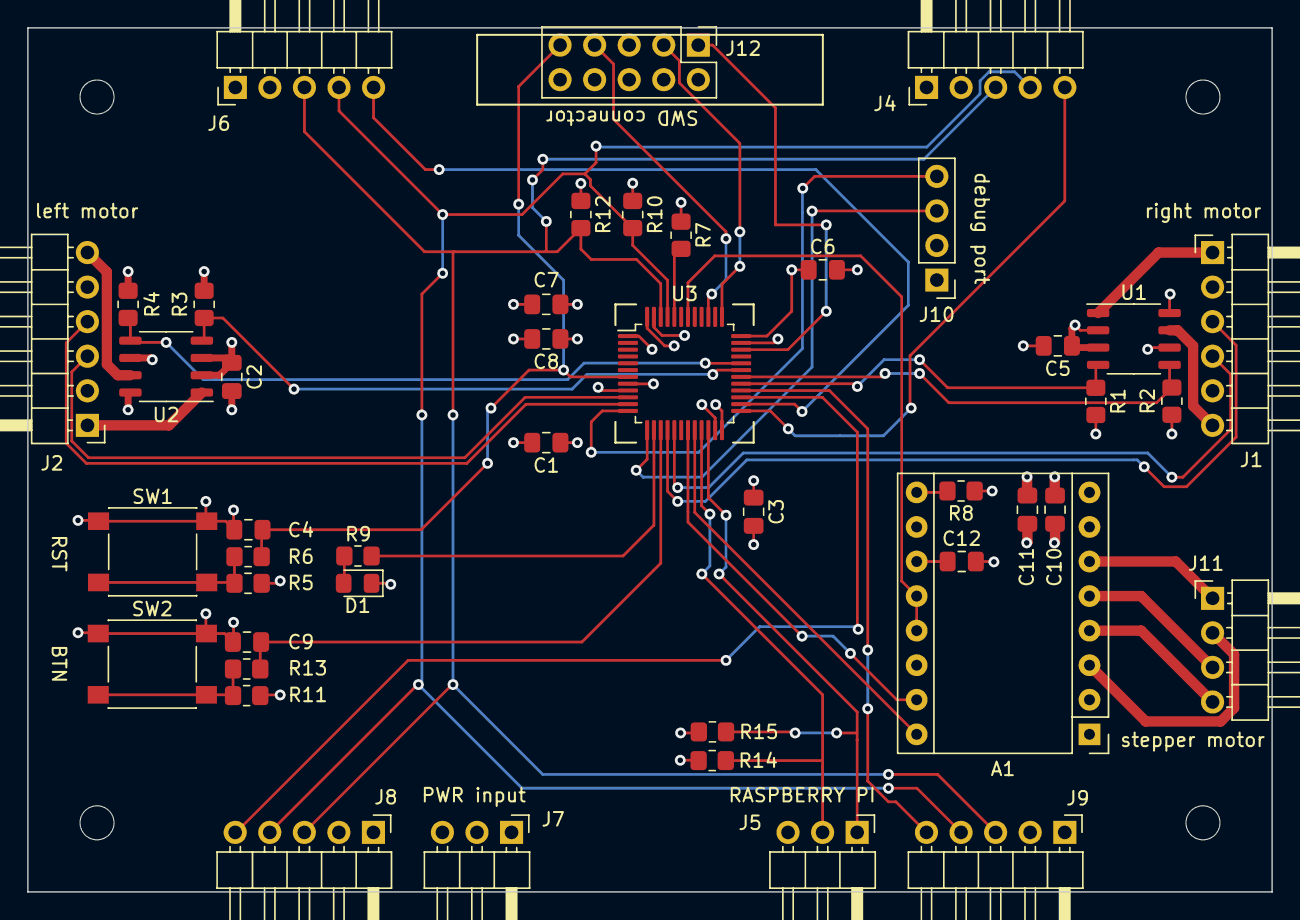
[picture p28: board movement-control.kicad_pcb from above]

Board: 4 copper layers, 91.4 x 63.5 mm, 49 parts (0 on the bottom side), 43 nets.

Other parts of the board:
REF01, REF02, REF03, REF04: MountingHole_2.5mm
