GaryBlackbourne/raspberry-robot/firmware/modules/main/src/motor_functions.c

#include "stm32f1xx_hal.h"
#include <stdint.h>

#include "motor_functions.h"
#include "command_parser.h"
#include "motor_parameters.h"

extern TIM_HandleTypeDef htim1;

static inline void set_right_forward_pwm(uint16_t pwm) { htim1.Instance->CCR1 = pwm; }
static inline void set_right_reverse_pwm(uint16_t pwm) { htim1.Instance->CCR2 = pwm; }
static inline void set_left_forward_pwm(uint16_t pwm)  { htim1.Instance->CCR3 = pwm; }
static inline void set_left_reverse_pwm(uint16_t pwm)  { htim1.Instance->CCR4 = pwm; }

void set_motor_speed(Motors motors, int32_t speed) {

    int pwm = speed;

    if (speed < 0) {
        set_motor_pwm(motors, MotorDirectionBackward, pwm);
    } else {
        set_motor_pwm(motors, MotorDirectionForward, pwm);
    }
}


void set_motor_pwm(Motors motors, MotorDirection dir, uint16_t pwm16){
    if (motors & MotorRight) {
        switch (dir) {
        case MotorDirectionForward:
            set_right_forward_pwm(pwm16);
            set_right_reverse_pwm(0);
            break;
        case MotorDirectionBackward:
            set_right_forward_pwm(0);
            set_right_reverse_pwm(pwm16);
            break;
        }
    }
    if (motors & MotorLeft) {
        switch (dir) {
        case MotorDirectionForward:
            set_left_forward_pwm(pwm16);
            set_left_reverse_pwm(0);
            break;
        case MotorDirectionBackward:
            set_left_forward_pwm(0);
            set_left_reverse_pwm(pwm16);
            break;
        }
    }
}

uint16_t duty_cycle(uint8_t duty_cycle) {
    if (duty_cycle > 100) {
        return 65535;
    }
    return ((65535 * duty_cycle) / 100);
}


/**
Speed is measured by the difference of an encoder counter. The difference is
calculated by IRQhandler which does run at 10ms period (100 Hz). The calculated
speed is in mm/s unit.
 */
inline float calculate_speed(int16_t cnt) {
    float s = (WHEEL_CIRCUMFERENCE * cnt) / (INCREMENTS_PER_ROUND * GEAR_RATIO); // distance in mm
    float t = 0.010;                                                             // time between measurements
    float velocity = s / t;                                                      // speed calculation formula
    return velocity;
}

uint16_t _abs(int16_t num) {
    return (num < 0) ? -num : num;
}

int16_t _round(float num) {
    if (num > 0) {
        return (int16_t)(num + 0.5);
    } else {
        return (int16_t)(num - 0.5);
    }
}
