GaryBlackbourne/raspberry-robot/firmware/modules/main/inc/robot_tasks.h

#ifndef _ROBOT_TASKS_H
#define _ROBOT_TASKS_H

#include "FreeRTOS.h"
#include "task.h"

#define RX_QUEUE_LENGTH 5
#define RX_BUFFER_LENGHT 17   /* based on the longest possible received command: svrl-aaaabbbb\r\n\0 */ 

#define TX_QUEUE_LENGTH 5
#define TX_BUFFER_LENGTH 20   /* based on the longest possible answer: aaaabbbbccccdddd\r\n\0 */

#define MOTOR_CONTROL_TASK_DELAY_MS 10

/* #define tskRX_PROCESSOR_PRIORITY tskIDLE_PRIORITY + 1 */
/* #define tskTX_PROCESSOR_PRIORITY tskIDLE_PRIORITY + 2 */
/* #define tskMOTOR_CONTROL_PRIORITY tskIDLE_PRIORITY + 3 */

/* Index type to address TaskList array for the appropriate task handle */
enum RobotTaskIndex {
    TaskIdx_RxProcessor = 0,
    TaskIdx_TxProcessor = 1,
};

/* Task initializer function */
BaseType_t xInitRobotTasks();

/* Task for serial communication */
void vTaskTxProcessor(void *vp);
void vTaskRxProcessor(void *vp);
void vTaskMotorControl(void *vp);
void vTaskSensorReader(void *vp);

#endif
