GaryBlackbourne/raspberry-robot/firmware/modules/main/src/robot_globals.c

/**
   This file contains all the globals the robot use for functionality.
 */
#include "FreeRTOS.h"
#include "queue.h"
#include "robot_internals.h"
#include "semphr.h"

#include "stm32f1xx_hal.h"
#include "stm32f1xx_hal_uart.h"



// FreeRTOS
SemaphoreHandle_t TxQueueRdy;
QueueHandle_t RxQueue;
QueueHandle_t TxQueue;
SemaphoreHandle_t TxDMALock;

// HAL Peripherals
UART_HandleTypeDef huart2;
I2C_HandleTypeDef hi2c1;
TIM_HandleTypeDef htim1;
TIM_HandleTypeDef htim2;
TIM_HandleTypeDef htim3;
TIM_HandleTypeDef htim4;
UART_HandleTypeDef huart2;
DMA_HandleTypeDef hdma_usart2_rx;
DMA_HandleTypeDef hdma_usart2_tx;

volatile RobotInternals robot;

// 
