GaryBlackbourne/raspberry-robot/firmware/modules/main/inc/robot_globals.h

#ifndef _ROBOT_GLOBALS_H
#define _ROBOT_GLOBALS_H

/* Struct containing the robot internal parameters */
#include <stdint.h>
typedef struct RobotInternals {

    /* /\* values of the ranging sensor: *\/ */
    /* struct { */
    /* 	uint32_t forward; */
    /* 	uint32_t right; */
    /* 	uint32_t backward; */
    /* 	uint32_t left; */
    /* } distance; */

    /* Encoder data struct */
    struct {
        int16_t right_current;
        int16_t right_previous;
        
        int16_t left_current;
        int16_t left_previous;
    } encoder;
    
    /* The actual measured speed */
    struct {
	int32_t right;
	int32_t left;
    } actual_speed;

    /* Target speed which is to be approximated by motor control */
    struct {
	uint32_t right;
	uint32_t left;
    } target_speed;

} RobotInternals;

#endif
