GaryBlackbourne/raspberry-robot/firmware/modules/vl53l1/platform/vl53l1_platform.c

/*
 * This file is part of VL53L1 Platform
 *
 * Copyright (c) 2016, STMicroelectronics - All Rights Reserved
 *
 * License terms: BSD 3-clause "New" or "Revised" License.
 *
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
 * 3. Neither the name of the copyright holder nor the names of its
 * contributors may be used to endorse or promote products derived from this
 * software without specific prior written permission.
 *
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
 */

#include "vl53l1_platform.h"
#include "stm32f1xx_hal.h"
#include "stm32f1xx_hal_def.h"
#include "stm32f1xx_hal_i2c.h"
#include "vl53l1_error_codes.h"
#include "vl53l1_types.h"
#include <stdint.h>

#define I2C_TIME_OUT_BASE 10
#define I2C_TIME_OUT_BYTE 1

extern I2C_HandleTypeDef hi2c1;
uint8_t _I2CBuffer[256];

void mymemcpy(void* dest, const void* src, size_t n) {
    char* _dest = (char*)dest;
    char* _src  = (char*)src;
    for (size_t i = 0; i < n; i++) {
        _dest[i] = _src[i];
    }
}

int _I2CWrite(uint16_t dev, uint8_t* pdata, uint32_t count) {
    int status;
    int i2c_time_out = I2C_TIME_OUT_BASE + count * I2C_TIME_OUT_BYTE;

    status = HAL_I2C_Master_Transmit(&hi2c1, dev, pdata, count, HAL_MAX_DELAY);
    if (status) {
        // VL6180x_ErrLog("I2C error 0x%x %d len", dev->I2cAddr, len);
        // XNUCLEO6180XA1_I2C1_Init(&hi2c1);
    }
    return status;
}

int _I2CRead(uint16_t dev, uint8_t* pdata, uint32_t count) {
    int status;
    int i2c_time_out = I2C_TIME_OUT_BASE + count * I2C_TIME_OUT_BYTE;

    status
        = HAL_I2C_Master_Receive(&hi2c1, dev | 1, pdata, count, HAL_MAX_DELAY);
    if (status) {
        // VL6180x_ErrLog("I2C error 0x%x %d len", dev->I2cAddr, len);
        // XNUCLEO6180XA1_I2C1_Init(&hi2c1);
    }
    return status;
}

int8_t VL53L1_WriteMulti(uint16_t dev, uint16_t index, uint8_t* pdata,
                         uint32_t count) {

    int status_int;
    VL53L1_Error Status = VL53L1_ERROR_NONE;
    if (count > sizeof(_I2CBuffer) - 1) {
        return VL53L1_ERROR_INVALID_PARAMS;
    }
    _I2CBuffer[0] = index >> 8;
    _I2CBuffer[1] = index & 0xFF;
    mymemcpy(&_I2CBuffer[2], pdata, count);
    status_int = _I2CWrite(dev, _I2CBuffer, count + 2);
    if (status_int != 0) {
        Status = VL53L1_ERROR_CONTROL_INTERFACE;
    }
    return Status;
}

int8_t VL53L1_ReadMulti(uint16_t dev, uint16_t index, uint8_t* pdata,
                        uint32_t count) {
    VL53L1_Error Status = VL53L1_ERROR_NONE;
    int32_t status_int;

    _I2CBuffer[0] = index >> 8;
    _I2CBuffer[1] = index & 0xFF;
    status_int    = _I2CWrite(dev, _I2CBuffer, 2);
    if (status_int != 0) {
        Status = VL53L1_ERROR_CONTROL_INTERFACE;
        goto done;
    }
    status_int = _I2CRead(dev, pdata, count);
    if (status_int != 0) {
        Status = VL53L1_ERROR_CONTROL_INTERFACE;
    }
done:
    return Status;
}

int8_t VL53L1_WrByte(uint16_t dev, uint16_t index, uint8_t data) {
    VL53L1_Error Status = VL53L1_ERROR_NONE;
    int32_t status_int;

    _I2CBuffer[0] = index >> 8;
    _I2CBuffer[1] = index & 0xFF;
    _I2CBuffer[2] = data;

    status_int = _I2CWrite(dev, _I2CBuffer, 3);
    if (status_int != 0) {
        Status = VL53L1_ERROR_CONTROL_INTERFACE;
    }
    return Status;
}

int8_t VL53L1_WrWord(uint16_t dev, uint16_t index, uint16_t data) {
    VL53L1_Error Status = VL53L1_ERROR_NONE;
    int32_t status_int;

    _I2CBuffer[0] = index >> 8;
    _I2CBuffer[1] = index & 0xFF;
    _I2CBuffer[2] = data >> 8;
    _I2CBuffer[3] = data & 0x00FF;

    status_int = _I2CWrite(dev, _I2CBuffer, 4);
    if (status_int != 0) {
        Status = VL53L1_ERROR_CONTROL_INTERFACE;
    }
    return Status;
}

int8_t VL53L1_WrDWord(uint16_t dev, uint16_t index, uint32_t data) {
    VL53L1_Error Status = VL53L1_ERROR_NONE;
    int32_t status_int;
    _I2CBuffer[0] = index >> 8;
    _I2CBuffer[1] = index & 0xFF;
    _I2CBuffer[2] = (data >> 24) & 0xFF;
    _I2CBuffer[3] = (data >> 16) & 0xFF;
    _I2CBuffer[4] = (data >> 8) & 0xFF;
    _I2CBuffer[5] = (data >> 0) & 0xFF;
    status_int    = _I2CWrite(dev, _I2CBuffer, 6);
    if (status_int != 0) {
        Status = VL53L1_ERROR_CONTROL_INTERFACE;
    }
    return Status;
}

int8_t VL53L1_RdByte(uint16_t dev, uint16_t index, uint8_t* data) {
    VL53L1_Error Status = VL53L1_ERROR_NONE;
    int32_t status_int;

    _I2CBuffer[0] = index >> 8;
    _I2CBuffer[1] = index & 0xFF;
    status_int    = _I2CWrite(dev, _I2CBuffer, 2);
    if (status_int) {
        Status = VL53L1_ERROR_CONTROL_INTERFACE;
        goto done;
    }
    status_int = _I2CRead(dev, data, 1);
    if (status_int != 0) {
        Status = VL53L1_ERROR_CONTROL_INTERFACE;
    }
done:
    return Status;
}

int8_t VL53L1_RdWord(uint16_t dev, uint16_t index, uint16_t* data) {
    VL53L1_Error Status = VL53L1_ERROR_NONE;
    int32_t status_int;

    _I2CBuffer[0] = index >> 8;
    _I2CBuffer[1] = index & 0xFF;
    status_int    = _I2CWrite(dev, _I2CBuffer, 2);

    if (status_int) {
        Status = VL53L1_ERROR_CONTROL_INTERFACE;
        goto done;
    }
    status_int = _I2CRead(dev, _I2CBuffer, 2);
    if (status_int != 0) {
        Status = VL53L1_ERROR_CONTROL_INTERFACE;
        goto done;
    }

    *data = ((uint16_t)_I2CBuffer[0] << 8) + (uint16_t)_I2CBuffer[1];
done:
    return Status;
}

int8_t VL53L1_RdDWord(uint16_t dev, uint16_t index, uint32_t* data) {
    VL53L1_Error Status = VL53L1_ERROR_NONE;
    int32_t status_int;

    _I2CBuffer[0] = index >> 8;
    _I2CBuffer[1] = index & 0xFF;
    status_int    = _I2CWrite(dev, _I2CBuffer, 2);
    if (status_int != 0) {
        Status = VL53L1_ERROR_CONTROL_INTERFACE;
        goto done;
    }
    status_int = _I2CRead(dev, _I2CBuffer, 4);
    if (status_int != 0) {
        Status = VL53L1_ERROR_CONTROL_INTERFACE;
        goto done;
    }

    *data = ((uint32_t)_I2CBuffer[0] << 24) + ((uint32_t)_I2CBuffer[1] << 16)
            + ((uint32_t)_I2CBuffer[2] << 8) + (uint32_t)_I2CBuffer[3];
done:
    return Status;
}

int8_t VL53L1_WaitMs(uint16_t dev, int32_t wait_ms) {
    (void)dev;
    HAL_Delay(wait_ms);
    return VL53L1_ERROR_NONE;
}

VL53L1_Error VL53L1_WaitUs(uint16_t dev, int32_t wait_us){
	(void)dev;
	HAL_Delay(wait_us/1000);
    return VL53L1_ERROR_NONE;
}

VL53L1_Error VL53L1_GetTickCount(uint32_t* ptick_count_ms) {

    /* Returns current tick count in [ms] */

    VL53L1_Error status = VL53L1_ERROR_NONE;

    //*ptick_count_ms = timeGetTime();
    *ptick_count_ms = 0;

    return status;
}

VL53L1_Error VL53L1_UpdateByte(uint16_t Dev, uint16_t index, uint8_t AndData,
                               uint8_t OrData) {
    VL53L1_Error Status = VL53L1_ERROR_NONE;
    uint8_t data;

    Status = VL53L1_RdByte(Dev, index, &data);
    if (Status) {
        goto done;
    }
    data   = (data & AndData) | OrData;
    Status = VL53L1_WrByte(Dev, index, data);
done:
    return Status;
}
