GaryBlackbourne/raspberry-robot/firmware/modules/main/src/tasks/rx_processor.c

#include "FreeRTOS.h"
#include "portmacro.h"
#include "queue.h"
#include "semphr.h"
#include "stdbool.h"

#include "stm32f1xx_hal.h"
#include "stm32f1xx_hal_uart.h"

#include "command_parser.h"
#include "robot_tasks.h"
#include <stdint.h>

extern UART_HandleTypeDef huart2;
extern QueueHandle_t RxQueue;

extern SemaphoreHandle_t TxQueueRdy;

void vTaskRxProcessor(void* vp) {
    (void)vp;

    // init queue
    RxQueue = xQueueCreate(RX_QUEUE_LENGTH, sizeof(char*));

    // rx string buffer
    char* rx_buffer = NULL;

    // struct for current command
    Command cmd;

    // wait for tx semaphore before running
    xSemaphoreTake(TxQueueRdy, portMAX_DELAY);
    xSemaphoreGive(TxQueueRdy);

    // enable usart
    __HAL_UART_ENABLE_IT(&huart2, UART_IT_RXNE);

    while (1) {
        // wait for message in queue
        while (xQueueReceive(RxQueue, &rx_buffer, portMAX_DELAY) != pdTRUE) {}

        // parse command string to command struct
        if (parse_command(rx_buffer, &cmd) != 0) {
            // this is a false package, we throw it away
            send_response(Unknown);
            continue;
        }

        // send 'acknowledge' character [a]
        send_response(Acknowledge);

        // execute command struct
        if (execute_command(&cmd) != 0) {
            /* internal error happens */
            send_response(Error);
            continue;
        }

        // send 'done' character [d]
        send_response(Done);
    }
}
