GaryBlackbourne/raspberry-robot/(commit log)

2022-03-10 Initiate kicad project
    [movement-control.kicad_pcb, movement-control.kicad_sch]
2022-03-11 Add motor driver to partlist
    [movement-control.kicad_sch]
2022-03-11 Add PCB design for control module
    [movement-control.kicad_sch]
2022-03-11 Reposition schematic elements
    [movement-control.kicad_sch]
2022-03-11 Add capacitor to stepper motor driver, and add pdf schematic
    [movement-control.kicad_sch]
2022-03-18 Apend parts list, and finish schematics
    [movement-control.kicad_sch]
2022-03-18 Created power supply project
    [power-supply-unit.kicad_pcb, power-supply-unit.kicad_sch]
2022-03-18 Add power supply module schematic to project
    [power-supply-unit.kicad_sch]
2022-03-25 Add connectors and organize PWR supply schematic
    [power-supply-unit.kicad_sch]
2022-03-25 Update gitignore
    [power-supply-unit.kicad_sch]
2022-03-25 Create basic layout design for the power supply module
    [power-supply-unit.kicad_pcb]
2022-03-26 Add power supply pcb layout
    [movement-control.kicad_sch, power-supply-unit.kicad_pcb, power-supply-unit.kicad_sch]
2022-04-28 Add resistor footprints to ctrl board
    [movement-control.kicad_sch]
2022-04-28 Add footprints to ctrl board
    [movement-control.kicad_sch]
2022-04-30 Add auto saved files to gitignore
    Fix motor driver power inputs.
    Add PWR_FLAGs to 3V3, 6V and GND
    [movement-control.kicad_sch]
2022-04-30 Fix servo driver capacitors
    connected to 3v3 instead of 6V
    [movement-control.kicad_sch]
2022-04-30 Fix wrong name for servo motor connectors
    [movement-control.kicad_sch]
2022-05-04 Modify SWD connector schematic, and add correct footprints
    [movement-control.kicad_sch]
2022-05-04 Fix connected power and gnd
    Connected power and gnd fixed in motor output power labels. Also PWR flags were removed, and power outputs were created at PWR_CONNECTOR
    [movement-control.kicad_sch]
2022-05-04 Fix motor signal bug, and add footprint to movement-control
    [movement-control.kicad_pcb, movement-control.kicad_sch]
2022-05-04 Add mounting holes to PSU
    [power-supply-unit.kicad_pcb]
2022-09-28 Add initial firmware to project
    [stm32f1x.cfg]
2022-10-07 Redesign PWR supply to match real part footprints
    [power-supply-unit.kicad_pcb, power-supply-unit.kicad_sch]
2022-10-08 Fix small errors, add more stitching vias
    [power-supply-unit.kicad_pcb]
2022-11-03 Rework firmware structure
    - several functions are now placed in different files to make it easy to
    find stuff.
    - usart communication is in working condition, can acknowledge commands
    and use notifications to turn led on and off.
    - fix a bug in clock management function, where the exact same bytes
    were ANDed, and thus made incorrect, but working code.
    - Add tasks which are final tasks, and task creation is properly
    monitored now.
    [main.c, pro_IRQ.c, pro_driver_clock.c, pro_driver_gpio.c, pro_driver_led.c, pro_driver_timer.c, pro_driver_usart.c, pro_helpers.c]
2022-11-03 FIRMWARE: Fix incorrect code in clock selection
    Rewrite RCC CFGR settings to be more readable
    [pro_driver_clock.c]
2022-11-17 Minor redesign of vias on pwr supply
    [power-supply-unit.kicad_pcb]
2022-11-17 Add i2c basic functions to project
2022-11-17 Add proper pwm functionality with timers
2022-11-17 Add test motor task for pwm testing
2022-11-17 Add i2c interrupt function
2022-11-17 Fix small inaccuracy in led setup
    [pro_driver_led.c]
2023-08-10 Fix mounting hole position inaccuracy with pwr-supply
    [power-supply-unit.kicad_pcb]
2023-08-11 Add mechanical drawings and datasheet for battery nest
    [frame.dxf]
2023-08-11 Format link for range sensor
2023-09-11 Added battery link
2024-03-22 Change build system for the firmware and updated gitignores
    [stm32f1x.cfg]
2024-03-25 Fix bugs, and make build system work
    [main.c]
2024-03-28 Remove old bsp layer, and add new task with uart
2024-04-02 Comment ranging sensor parts
2024-04-06 Add uart interrupt reception functionality
2024-04-06 Add comments and define for command chain length
2024-04-12 Add command parsing capability and fixed interrupt queuing
    [command_parser.c, command_parser.h, robot_tasks.c, rx_processor.c]
2024-04-15 Add DMA transmit functionality
2024-04-15 Add transmit task, dma sync and fix task creation
    [command_parser.c, robot_globals.c, robot_tasks.c, robot_tasks.h, tx_processor.c]
2024-04-16 Add pwm test code to main
2024-04-17 Add motor control as a task to the system with encoder and pwm generation
2024-04-18 Adjust USART and DMA IRQ priorities
2024-04-18 Add motor controlling functions
2024-04-28 Add pid functions
    The PID implementation was taken from a repository:
    https://github.com/pms67/PID.git
2024-04-29 Add motor parameters and defines
2024-04-29 Add motor control task and functions
2024-04-29 Fix missing function declaration
    [command_parser.h]
2024-04-29 Add VL53L1CB ultra lite driver, and platform code
2024-05-01 Add sensor functionality
    Add sensor reader task
    Add sensor handler functions
    Fix pinout for i2c
    Add driver tweaks
    [motor_control.c, robot_tasks.c, robot_tasks.h, sensor.c, sensor_functions.c, sensor_functions.h, vl53l1_platform.c]
2024-05-01 Fix sensor address function and remove binaries form vc
    [sensor_functions.c]
2024-05-01 Add working 4 sensor driver
2024-05-02 Fix build errors, add motor symmetry
    [motor_control.c, robot_internals.h, sensor.c]
2024-05-03 Add pid frame, and command execution functions
2024-05-09 Synchronise processes, and fix bugs
    [command_parser.c, command_parser.h, motor_control.c, robot_internals.c]
2024-05-16 Add timeout for motor controll
2024-05-17 Fix sensor directions and speed calculation
    [motor_control.c, motor_functions.c, motor_parameters.h, sensor.c]
